CmdrZin/chips_pic_examples/README.md

chips_pic_examples
==================

Examples of PIC processor code in C and ASM. Mostly PIC12, PIC18, and dsPIC33 families.

| Name | Description |
|---|---|
|dsPIC33 | dsPIC33 board and code for simultaneous four channel ADC.  |
