CmdrZin/chips_pic_examples/dsPIC33/NewFasterDSP.rtf

NewFasterDSP.rtf
23jun20
04aug20

https://www.microchip.com/wwwproducts/en/dsPIC33CK256MP202 - dsPIC33CK256MP202 - No CAN, 3.5 MSPs, 12-bit.

https://www.microchip.com/wwwproducts/en/dsPIC33CK256MP202 - dsPIC33CK256MP502 - w/ CAN

- SST26VF064B 64Mb 104MHz Serial Flash 8pin

http://www.swarthmore.edu/NatSci/echeeve1/Ref/SingleSupply/SingleSupply.html - EDU web page for single
supply opamp circuits.

MCP602-I/P - Rail-to-Rail (100mv) Single supply 2.7v to 6.0v Dual Opamp DIP8
http://ww1.microchip.com/downloads/en/AppNotes/00682c.pdf - App note for opamps in embedded systems.
Use MCP6004-I/P Rail-to-Rail Quad 1.8v - 6.0v DIP14 1MHz
