CmdrZin/chips_pic_examples/dsPIC33/Notes_dsPIC33rev3.rtf

Notes_dsPIC33rev3.rtf
05aug20 ndp
12aug20

Notes on new dsPIC33 rev 3 board (Using DSPIC33EP32MC202)

CmdrZin : gelf..MC!
chip@gameactive.org

ref1: dsPIC33EPxxx.pdf - Data sheet.
ref2: dsPIC33_FRM_Osc.pdf (S7.pdf) - Oscillator configuration and uses manual (DS70580C).
ref3: dsPIC33_FRM_ADC.pdf (S16.pdf) - Analog-to-Digital Convertor users manual (DS70621C).
ref4: (see also) ..\DemoBoards\dsPIC33\dsPIC33_Sampler.X\docs DN and LN docs.
ref5: https://www.ftdichip.com/Products/ICs/FT232H.htm - FTDI chip ref

dsPIC33EP32MC202..Upgrade to DSPIC33EP512MC202 for 48k of RAM.
Power: 36 to 55 ma @ 3.3v @ 60 MIPS Use 0.1uF + 0.001uf at Vdd:Vss pairs and AVdd:AVss pins.[1] Sect 2.0 (see also pg30)
16uH inductor to Vdd. [1] pg 30 Fig 2-1
10uF Tantalum on Vcap (ESR < 1.0 Ohm). [1] pg 30 Fig 2-1
10uF Electrolytic local Vdd power tank cap. [1] pg 30 Fig 2-1
Jumper to disconnect /MCLR pin during debug and programming. [1] pg 30
IO: Unused pins should be driven LOW.[1] pg 32
CLOCK: Set Fvco = 240MHz. PLLPOST = 01 (div 4) for Fpllo = 60MHz

FTDI: https://www.ftdichip.com/Products/ICs/FT230X.html - FT230x chip $2.04 ea

https://www.microchip.com/mplab/mplab-x-ide - IDE v5.40 ..do FULL install (8,16,32 MCUs)
Harmony not installed. Some day maybe.
https://www.microchip.com/mplab/mplab-code-configurator - MCC..Tools > Plugins > MPLAB Code Configurator
https://www.microchip.com/mplab/compilers - Compiler Downloads > XC8, XC16, & XC32 for WIndows.
D:\Program Files\Microchip\<compiler folder>. If not adding to PATH, then
Run .exe file and config with Tools > Options > Embedded > Build Tools > Add or Scan to add compiler.
Resolve DSP pack needed. dsPIC33_Sampler builds..

New Schematic/Layout dsPIC33_Sampler_r3.sch, .pcb

Flash
SST25VF020B 2Mb SPI

Family differences[1]
dsPIC33EPxxxGP20x/50x - Have ECAN Interface. No PWM or Quadrature.
dsPIC33EPxxxMC20x/50x - Have PWM and Quadrature Interface. 20x -No ECAN. 50x - Has ECAN.
xxx Flash RAM
32 32k 4k dsPIC33EP32MC202
64 64k 8k
128 128k 16k
256 256k 32k
512 512k 48k

For FCY = 60 MHz [2]Sect 7.7.2.2 (error in Ex 7-2 code)
Let FOSC = 120 MHz
FIN = 7.37 MHz
Let FSYS = 240 MHz = FIN x (M/N1) = 7.37 x (65.13/2)
M = 65 (PLLDIV<8:0> = 63)
N1 = 2 .. (PLLPRE<4:0> + 2) .. PLLPRE<4:0> = 00000
FPLLI = FIN / N1 = 7.37 / 2 = 3.685 MHz < 8.0 MHz
FOSC = FSYS / N2 = 240 MHz / 2 = 120 MHz (119.76 MHz)
N2 = 2 .. (2 x (PLLPOST<1:0> + 1)) .. PLLPOST<1:0> = 0
Can uptune FRC (OSCTUN) a bit to get to 120 MHz if needed.

Configuring ADC
The 28-pin DIP only has 6 analog inputs and AN4 and AN5 are used by ISP programmer pins.
In ONE channel (12 bit) mode, AN0 goes to CH0.
In FOUR channel (10 bit) mode, AN3->CH0, AN0->CH1, AN1->CH2, and AN2->CH3. +Vref and -Vref can not be used.

TIMING
12 bit
TAD > 118ns TCONV = 14 TAD TSAMP >= 3 TAD [1]Table30-60
10 bit
TAD > 76ns TCONV = 12 TAD TSAMP >= 2 TAD [1]Table30-61
Set AD1CON3<7:0> to 4 (10bit) or 5(12bit) to get the correct TAD time.
FP = 1/60MHz = 16.7 ns
Set AD1CON3<7:0> to 4 (10bit) or 8(12bit) to get the correct TAD time.
Four conversions = 233kHz/4ch or 932kHz throughput.

Ground and Power layout
Use 5v for opamp.
LM386 LP filter set to ~16kHz ( 1k + 0.01uF ).
