CmdrZin/chips_pic_examples/dsPIC33/dsPIC33_serialExample.rtf

dsPIC33_serialExample.rtf
09sep19 ndp

see also D:\Downloads\Microchip\web-platform-dsPIC33Intro.v1a.zip

SEND
#define FCY 30000000

#include <xc.h>

#include <stdio.h>

#include <delay.h>

#include <libpic30.h>

#include <math.h>

#include <p30F4011.h>

_FOSC(CSW_FSCM_OFF & FRC_PLL16); // Fosc=16x7.5MHz, i.e. 30 MIPS
_FWDT(WDT_OFF); // Watchdog timer off
_FBORPOR(MCLR_DIS);

void UART_Init ( void )
{
_TRISF3 = 0; //Look for the exact TX/RX pins of your pic device
_TRISF2 = 1; //TX pin must be set as output port and RX input

U1BRG = 7; // 115000 baud rate @ 30 MIPS
U1MODEbits.UARTEN = 1; // Enable UART
}

int main( void )
{
UART_Init();

while( 1 )
{
//To print a variable
sprintf(array,"%d",variable);
printf(array);
printf("\r\n");

//To print text
printf("Greetings from Pakistan\r\n");

__delay_ms(1000);
}
}

RECEIVE
#define FCY 30000000

#include <xc.h>

#include <stdio.h>

#include <libpic30.h>

#include <uart.h>

#include <delay.h>

#include <p30F4011.h>

// Configuration settings
_FOSC(CSW_FSCM_OFF & FRC_PLL16); // Fosc=16x7.5MHz, Fcy=30MHz
_FWDT(WDT_OFF); // Watchdog timer off
_FBORPOR(MCLR_DIS); // Disable reset pin

char data;

void Interrupt_Init( void )
{
IEC0bits.U1RXIE = 1;
}

void __attribute__((interrupt, auto_psv)) _U1RXInterrupt( void )
{
_LATD0 = 1;
__delay_ms(500);
_LATD0 = 0;

data = U1RXREG;

if ( U1STAbits.OERR = 1 )
{
U1STAbits.OERR = 0;
}
IFS0bits.U1RXIF = 0;
}

int main()
{
// Set all port D pins as outputs
_TRISD0 = 0;

// Setup UART - most default options are fine
UART_Init();
Interrupt_Init();

while(1)
{
__delay_ms(1000);

}

return 0;
}
