CmdrZin/chips_pic_examples/dsPIC33/Notes_dsPIC33.rtf

Notes_dsPIC33.rtf
20jan17 ndp
13jun20

Notes on dsPIC33 controller (Using DSPIC33EP32MC202)

CmdrZin : gelf..MC!
chip@gameactive.org

ref1: dsPIC33EPxxx.pdf - Data sheet.
ref2: dsPIC33_FRM_Osc.pdf - Oscillator configuration and uses manual.
ref3: dsPIC33_FRM_ADC.pdf - Analog-to-Digital Convertor users manual.
ref4: (see also) ..\DemoBoards\dsPIC33\dsPIC33_Sampler.X\docs DN and LN docs.

https://www.microchip.com/mplab/mplab-x-ide - IDE v5.40 ..do FULL install (8,16,32 MCUs)
Harmony not installed. Some day maybe.
https://www.microchip.com/mplab/mplab-code-configurator - MCC..Tools > Plugins > MPLAB Code Configurator
https://www.microchip.com/mplab/compilers - Compiler Downloads > XC8, XC16, & XC32 for WIndows.
D:\Program Files\Microchip\<compiler folder>. If not adding to PATH, then
Run .exe file and config with Tools > Options > Embedded > Build Tools > Add or Scan to add compiler.
Resolve DSP pack needed. dsPIC33_Sampler builds..

09sep19
d/l MLA (libraries for USB and crypto) [https://www.microchip.com/mplab/microchip-libraries-for-applications]
Upgrade to MPLAB XIDE 5.25.
16sep19
Remove MIC preamp. Correct Serial Flash interface. Add decoupling to opamps. Update I2C layout.
New Schematic/Layout dsPIC33_Sampler_r1.sch, .pcb

Flash
SST25VF020B 2Mb SPI

Family differences[1]
dsPIC33EPxxxGP20x/50x - Have ECAN Interface. No PWM or Quadrature.
dsPIC33EPxxxMC20x/50x - Have PWM and Quadrature Interface. 20x -No ECAN. 50x - Has ECAN.
xxx Flash RAM
32 32k 4k dsPIC33EP32MC202
64 64k 8k
128 128k 16k
256 256k 32k
512 512k 48k

NOTE: dsPIC33EPxxGS50x has 5 simultanious 12 bit ADC and 2 12 bit DAC @ 3.5 MHz.

Configuring the dsPIC33 CPU clock
Uses on-chip PLL to boost osc to faster CPU clock.[1]Sect 9
Fuse bits select osc source.[2]Sect 7.1
Using internal FRC @ 7.37 MHz.[1]Table 30-19
FOSCSEL: FNOSC<2:0> = 0b111 for start up.[2]Sect 7.3
FOSC: 0003 - POSCMD<1:0> = 0b11 disabled

Inst Clock: FCY = FOSC/2 (70 MHz max)
FOSC = FPLLO <= 140 MHz. [2]Fig 9-2
FPLLO = FIN x (M /(N1 x N2))
N1 = PLLPRE + 2
N2 = 2 x (PLLPOST + 1)
M = PLLDIV + 2
120 MHz < FVCO < 340 MHz
FVCO = FIN x (M/N1)

OSCCON settings 0b0rrr 0001 00r0 rrrs
NOSC<2:0> = 0b001 - Switch to FRC w/ div and PLL

CLKDIV settings
ROI = 0
DOZE<2:0> = 000
DOZEN = 0
FRCDIV<2:0> = 000
PLLPOST<1:0> (N2) = 00 (/2) or 01 (/4)
PLLPRE<4:0> (N1) = 0 (/ n+2)

PLLFBD settings
PLLDIV<8:0> (M) = y (/ y+2)

OSCTUN setting 0x0000 - no adjustment

REFOCON settings 0x0000 - disabled

For FCY = 70 MHz
Let FOSC = 140 MHz
FIN = 7.37 MHz
Let FSYS = 280 MHz = FIN x (M/N1) = 7.37 x ( 75.98/2)
M = 76 (PLLDIV<8:0> = 74)
N1 = 2 .. (PLLPRE<4:0> + 2) .. PLLPRE<4:0> = 00000
FPLLI = FIN / N1 = 7.37 / 2 = 3.685 MHz < 8.0 MHz
FOSC = FSYS / N2 = 280 MHz / 2 = 140 MHz (140.03 MHz)
N2 = 2 .. (2 x (PLLPOST<1:0> + 1)) .. PLLPOST<1:0> = 0
Can detune FRC (OSCTUN) a bit to get to 140 MHz if needed or use M=75 to get 138.2 MHz.

For FCY = 60 MHz [2]Sect 7.7.2.2 (error in Ex 7-2 code)
Let FOSC = 120 MHz
FIN = 7.37 MHz
Let FSYS = 240 MHz = FIN x (M/N1) = 7.37 x (65.13/2)
M = 65 (PLLDIV<8:0> = 63)
N1 = 2 .. (PLLPRE<4:0> + 2) .. PLLPRE<4:0> = 00000
FPLLI = FIN / N1 = 7.37 / 2 = 3.685 MHz < 8.0 MHz
FOSC = FSYS / N2 = 240 MHz / 2 = 120 MHz (119.76 MHz)
N2 = 2 .. (2 x (PLLPOST<1:0> + 1)) .. PLLPOST<1:0> = 0
Can uptune FRC (OSCTUN) a bit to get to 120 MHz if needed.

For FCY = 40 MHz
Let FOSC = 80 MHz
FIN = 7.37 MHz
Let FSYS = 160 MHz = FIN x (M/N1) = 7.37 x (65.13/3)
M = 65 (PLLDIV<8:0> = 63)
N1 = 3 .. (PLLPRE<4:0> + 2) .. PLLPRE<4:0> = 00001
FPLLI = FIN / N1 = 7.37 / 3 = 2.46 MHz < 8.0 MHz
FOSC = FSYS / N2 = 160 MHz / 2 = 80 MHz (79.84 MHz)
N2 = 2 .. (2 x (PLLPOST<1:0> + 1)) .. PLLPOST<1:0> = 0
Can uptune FRC (OSCTUN) a bit to get to 80 MHz if needed.

Configuring ADC
The 28-pin DIP only has 6 analog inputs and AN4 and AN5 are used by ISP programmer pins.
In ONE channel (12 bit) mode, AN0 goes to CH0.
In FOUR channel (10 bit) mode, AN3->CH0, AN0->CH1, AN1->CH2, and AN2->CH3. +Vref and -Vref can not be used.

TIMING
12 bit
TAD > 118ns TCONV = 14 TAD TSAMP >= 3 TAD [1]Table30-60
10 bit
TAD > 76ns TCONV = 12 TAD TSAMP >= 2 TAD [1]Table30-61
If using system clock for conversion, AD1CON3:ARDC=0, then
FP = FOSC/2 = FCY (if DOZE = 1) = 1/40MHz = 25 ns
Set AD1CON3<7:0> to 4 (10bit) or 5(12bit) to get the correct TAD time.
FP = 1/60MHz = 16.7 ns
Set AD1CON3<7:0> to 5 (10bit) or 8(12bit) to get the correct TAD time.
Four conversions = ~5.68us or 176kHz/4ch or 704kHz throughput.

AUTO-CONVERT
AD1CON3.SAMC<4:0> = 3 TAD
SSRCG = 0 SSRC<2:0> = 111

SIMULTANEOUS SAMPLING
AD1CON1.SIMSAM = 1
Test AD1IF bit for convsersion complete. (IFS0.AD1IF Interrupt flag, but currently not using interrupts.)
Total loop now at 195kHz for four channels, includes reading and running through IF block..try logic..ok.
Still works..save it..

Configuring UART (Sect 10, pg 10-14)
//*************************************************************
// Unlock Registers
//*************************************************************
__builtin_write_OSCCONL(OSCCON & ~(1<<6));

RB11/RP43 is mapped to U1RX RPINR18bits.U1RXR = 0 010 1011 (DataSheet pg 191, REGISTER 11-10)
RB10/RP42 is mapped to U1TX RPOR4bits.RP42R = 000001

(DataSheet TABLE 11-2)
RP43 = 010 1011
RP42 = 010 1010

//*************************************************************
// Lock Registers
//*************************************************************
__builtin_write_OSCCONL(OSCCON | (1<<6));

Set up BAUD rate. S17.pdf Example 5-1 pg18

Check U1STAbits.URXDA == 1 for data available. U1RXREG has data.
If U1STAbits.OERR == 1, set to 0 to continue.
Write to U1TXREG to send data.
TX and RX buffers are 4 level FIFOs.
