CmdrZin/chips_pic_examples/dsPIC33/UltraSonicArray/DN_UltraSonicArray.rtf

DN_UltraSonicArray.rtf
15jan17 ndp

Design Notes for an Ultra Sonic Array Imager/Sensor (finally..only been what..10 years since first consept?)

ref1:

Using dsPIC33 Sampler board. 70 MHz DSP with quad 250kHz simultainius sampling, 2Mb storage,
FTDI/USB/Bluetooth port, and I2C (both 5v and 3.3v).

40kHz transducers. One emitter, four receivers.

FFT at 40kHz for phase information. (ref linear array for radar papers and MatLab examples)
