CmdrZin/chips_pic_examples/dsPIC33/Processing3/Notes_Processing3.rtf

Notes_Processing3.rtf
05sept17 ndp

Notes on Using Processing3 with focus on Serial Comm and Graph/Text Displays

Processing3 is really a Java Applet to present a simplified framework.
Graphic coordinates based on 0,0 in upper left corner.
Use text( String, x1, y1, x2, y2) to display text in FONT defined.
hex(v) returns a String object of v converted into HEX.
