CmdrZin/chips_pic_examples/dsPIC33/dsPIC33_Sampler.X/docs/LN_dsPIC33_Sampler.rtf

LN_dsPIC33_Sampler.rtf
06jan17 ndp
15jul20

Log Notes for dsPIC33 High Speed Sampler

ref1: dsPIC33_FRM_Osc.pdf
ref2: dsPIC33_FRM_ADC.pdf

Target: Microchip dsPIC33 family, dsPIC33EP32MC202 @ 60Mips, 500kHz ADC, 2Mb serial Flash 10MHz

04sep19
TODO: Change I2C to revised layout. (../I2C_Reference/I2C_Ref.rtf)
Add Ext 5v input pins. Power 3.3 is usually from FTDI serial.

Open up MPLAB X IDE
File > New Project > Samples > dsPIC33 C Template (try this) > Next
Project Filename: dsPIC33_Sampler
Project Loacation: C:\Data\EmbeddedSystems\Demo Boards\dsPIC33
Project Folder: C:\Data\EmbeddedSystems\Demo Boards\dsPIC33\dsPIC33_Sampler.X .. Set as Main Project
Propertues > Configuration > Device > dsPIC33EP32MC202 > Apply .. hmm
Family: 16-bit DSCs (dsPIC33) > Device > dsPIC33EP32MC202 > Compiler Toolchains > XC16 > XC16 (v1.30) > Apply > OK
Toolbar: Config: XC16_dsPIC33EP512MU810..hmm..no source errors now..ok..
Use main.c for most.
Use user.c to init hardware.
Open getting_started.tx file in project browser.. go to Windows > Tasks to get a list of set up tasks..ok.
Step 1: Clean and Build..try build initial set up..ok..
Step 2: configuration_bits.c set up .. Window > PIC Memory Views > Configuration Bits
Use 7.7.2.2 Exp 7-2[1] code for internal osc @ 60 MHz .. also turn off watchdog .. gen code..cut-n-paste to configuration_bits.c
Add main() code to system.c: ConfigureOscillator() .. leave Disable WDT code.. Clean and Build..ok..
07jan17
Step 3: Skip for now. No interrupts.
Step 4: system.h, .c. Hmm..nothing at the moment. ConfigureOscillator(void) already there.
Step 5: user.c, .h .. Configure I/O, ADC, etc... just I/O for now. RB4 pin 11 as output. Add LED function setLed(bool).
make some guesses on code based on data sheet section 11. Do perif mapping later.
Step 6: add some trivial loop code to blink LED..ok..plug in Uo for 3.3v and ICD 3..hmm, wrong target..
try setting EP32 (copy of EP512) as configuration..clean/build..hmm..config bits unknown..delete offending lines..
hmm..since setting target in config, different bits available. Redo 7.7.2.2 Exp 7-2[1] for Osc and gen code..try c/b..
ok..try make and prog to device..hmm..no errors, but no LED..try debug..DOH..not inc count..FIX..hmm..
try debug again..hmm..only runs in Debug (but very slow)..clock issue?..hmm, left out last line..FIX..try again..same..
FNOSC = FRC 7.6 Table 7-4
try dropping clock..63 -> 10..debug is slower..no run yet..try N1=2..faster debug, no run..
try seting Analog to Digital..nope..add pull up to MCLR..YUP..runs now, but slow..code is minimal and flow is ok..
try..
FOSCEL:FNOSC=FRCPLL .. nope..
TUN<5:0> sets rate, NO, minor adj. FRCDIV..can control, starts at div 1..ok..USLESS RABBIT HOLE..
Was using int for counter, well half the time it's NEGATIVE and counter % ^ won't be 0 OR 6..FIX by using uint16_t
and ALL WORKS at speed (about 50 MHz).
08jan17
ADC[2] .. No DMA .. with OpAmps ..
AN0 Ch0 CH0Sx = 00000
AN1 Ch1
RB0 -Vref CH0Nx = 0, VCFG<2:0>
RB1 +Vref VCFG<2:0>
Use Section 16 Example code 16-1[2] .. put initAdc1() code in user.c:InitApp() ..
Set SIMSAM = 1 for simultaneous sampling..CHPS<1:0> for channels 0 and 1 .. 0 for now..
Change AD1CHS0 = 0x0000; to use AN0 .. add led blinks to measure acquisition time..
TODO: Use AD1CON2:VCFG = b001 for Ext +VRef and AVss (frees up RB0)
TODO: For two channel, set AD1CON2:CHPS = b01
try it.. hmm about 75kHz (13us) per .. ok .. add some code to check data to threshold .. hmm .. no response ..
try uint16_t .. nope .. oops, wrong port .. FIX .. ok, works. Can try other combinations later..
commit ..
NEXT: four channels using +Vref=Vdd and -Vref=Vss
Ch0: AN3/RB1 (5)
CH2: AN1 (3)
Ch1: AN0 (2)
Ch3: AN2/RB0 (4)
19jan17
Change over to new ADC configuration, four channels.
MOD: user.c,.h : InitApp() .. change to select 1 ch or 4 ch config.
MOD:main.c to select either one or four chanel adc..try it..hmm..oops..x0200 is not bit 10, x0400 is..fix..
PROBLEM: Target Device ID (0x0) does not match expected Device ID (0x1c010000)
NOTE: Add 10k pull-down to PGC and PGD lines. ICD3 issue fix.
One channel working with 12bit now..try 4 chan..works..a little slow (13.4us convert)..try internal RC osc
AD1CON3 = 0x8000; // ADRC:IntRC, SAMC:n\a, ADCS:n\a
better..(11.94us)..hmm..Sect 16[2] says to use 40MHz to get 1.1MHz..change clock set up per Ex 16-3.
MOD: system.c : ConfigureOscillator() .. better..go back to 70MHz and adj TaD value..still works..ok.
20jan17
MOD: main.c, user.c - Added auto-sample/auto-convert to FOUR channel adc code.
ALL: Added MIT license to code.
Hooked up LED to pin25 (RB14/PWM1)
MOD: main.c, user.c to enable RB14 as output and toggle with 3 nops between toggles .. works .. 0.12us pulse..
6 instruction in 0.12us -> 50MHz .. hmm .. put in 7 nops for 10 inst per edge .. 0.2us with some 0.16us areas ..
Seems TCY is 50MHz. Should be 60MHz or the saleae pod is off a bit..increase to 20 Tcy..hmm..0.36 and 0.40..
try 100 Tcy..1.68 & 1.72us -> 58 to 59 MHz..so 25 MHz sampling of pod is issue..ok..
Save ADC as test002..start PWM stuff..not simple..
17mar17
Board built up except for audio pre-amp..power up MPLAB X IDE..call test001 code..Make and Program Device..
50 Hz LED Blink..IT'S ALIVE!!!!..cool..need a 3.3v FTDI or Bluetooth to read out data..next up try ADC code..
09sep17
ICD 3.. Debug > Test ..make sure to select serial number and not just ICD 3..ok with test board..works now.
Insupported interrupt going to trap..turn OFF TX Intr..ok..hmm, trace register settings, S17.pdf Sect 5.0 TX..
MOD test001 to load U1TXREG when LED is turned on. Should work w/o intr..ok..trace intr service def..at 9600 too..
data seems inverted..hmm, http://microchipdeveloper.com/faq:77 - notes. Try in code..nope..try CCI syntax..
nope..(from trap.c) need a prototype of ISR??..try it..nope..try moving ISR into main()..YES??..hmm, put prototype
in main.c??..nope..try putting a function to call in serial.c..DOH, didn't add serial.c,.h to Projects > Source Files ..
FIX..Projects > Source Files > Add Existing Item.. and pick files..works now..sheesh..
NOTE: UTXINV bit controls output polarity.
NOTE: UTXBF bit = 1 if TX buffer fifo is full.
09sep19
Serial support. Add writeChar() and writeBuff(). ConfigureUART: dont use .bits for entire register set..
HAH, works now. Try for 115.2k now..change Processing3 code..ok, works..
12sep19
Revised ADC (test02)..5us -> 200KHz per 4 channel -> 800KHz total rate..cool..
TODO: Add interrupt service to transfer ADC data to buffer. Print out working, no interrupt yet.
13sep19
CHPS<1:0> = 1x = 3, ok.. SMPI<4:0> = 4 ? .. IFS0bits.AD1IF = 0, IPC3bits.AD1IP = 7 (highest), IEC0bits.AD1IE = 1 ..ok..
HAH, works now..format data out..ok, better. Now saving 512x4 samples in buffer.
17sep19
PWM .. ref: dsPIC33_FRM_PWM.pdf (S14.pdf) .. RB14/PWMH (RPI46) pin.
Use PWM1H. FP = 60HMz. IOCON1 and FCLCON1 are write-protected. (16.1.2 data sheet).
Use Standard Edge-aligned PWM.
PWMCON1bits.CAM = 0; // For Edge-Aligned mode.
ref: fig 14-35, Example 14.34
PHASE1 = 800; // period
PDC1 = 200; // duty cycle
DTR1 = 0; // Dead time
ALTDTR1 = 0;
IOCON1 = 0xCC00; // PWM Mode to Independent
PWMCON1 = 0x0200; // Ind time base, edge-align, independent duty cycle
FCLCON1 = 0x0003; // Configure Faults
PTCON2 = 0x0000; // 1:1 prescaler
PTCON = 0x8000; // Enable PWM Mode
add to system.c .. configurePWM() .. try it.. works.. 60000=2kHz, 12000=10kHz periods.
For interrupt, try
TRIG1 = 0x0010;
PWMCON1bits.TRGIEN = 1;
TRGCON1 = 0x0000;
IFS5bits.PWM1IF = 1; // enable by resetting interrupt flag?
IPC23bits.PWM1IP = 0b001; //interrupt priority level 0 .?
blah..
PTCONbits.SEIEN = 1;
nope..bug, fix..working..now to remove added code that may not be needed..TODO.
19sep19
Add audio code. Use Period=2048 (73.5kHz period sample time)
36750/256 = 143.5Hz so 146.83Hz (D3) 36750/x = 146.83, x=250.289. x*8 = 2002.
Test..185.2Hz..close..try 1800 accumStep ..=161.3Hz..try 1600..=142.8..1620..=144.9..use 1610.
610 -> 55.5 Hz..ok.
20sep19
Change R7 to 1k. Better. Added Tune code..add pause to notes..ok, working..
24sep19
Add envelope code..scaling problems..add P_IDLE state to end envelope, going back to P_ATTACK caused /0 error
due to counter at 0..fixed..steps have to equal 100% of duration or clicks are generated..working now.
28jun20
BUG: Four channel data is invalid.
Have interrupt place incrementing count as data into buffer to test transfer...works correctly..00 01 02 03..
So, ADC measured values have a problem..review manual Ch 16..system noise at about 200kHz..minor adjustments
to code..seems to work now.
15jul20
OpAmps clip at 2v. DC Bias is at 1.615v. Reduce signal. Audio still works. Snashot to SVN rev 340.

15jul20
Project rev 341.
Modify dsPIC + Processing3 O-display to show serial data.
1. Change serial format to add sync 0xAA 0x55 before data. Change data to be 16 bit. Modify Processing3 to accept.
Four channel is 8bit. One channel is 12bit.
New format: AA 55 Ch0H Ch0L Ch1H Ch1L Ch2H Ch2L Ch3H Ch3L 0A 11 bytes with '\n' terminator.
New SYNC Format: AA 50 2 8bit binary bytes. New buffer dump.
New Binary Format (Four Chanel): AA 55 Ch0 Ch1 Ch2 Ch3 6 8bit binary bytes
DSP side done..Looks ok on scope.
Do Processing3 side..

New Binary Format (One Chanel): AA 5N ChNH ChNL 4 12bit binary bytes. N = Chan

Dump entire buffer every 2k samples.
Add a zero, F8 to 08, crossing trigger to start collection.

2. Copy ..\Software\Processing3\OScope code to ..\Processing3\OScope4Ch and add in code from SerialTest002 then
modify to accept new format.
