CmdrZin/chips_pic_examples/dsPIC33/dsPIC33_Sampler.X/docs/DN_dsPIC33_Sampler.rtf

DN_dsPIC33_Sampler.rtf
26dec16 ndp
15jul20

Design Notes for dsPIC33 Sampler board

Using: dsPIC33EP32MC202 device

Target: Microchip dsPIC33 family, dsPIC33EPxxxMC202 @ 60Mips, 500kHz ADC, 2Mb serial Flash 10MHz

This board will evaluate the dsPIC33xxx for fast ADC 500kHz > 1100kHz(quad sample) and analog input circuits.
It is a 3.3v system and will need a translator for I2C to 5v systems.

Single channel audio tests use preamp into AN0 and PWM audio out. ADC is configured for 12bit 500kHz max.
Quad channel (ultrasonic) tests use AN0-3 and simultainiuos sampling. ADC is at 250kHz per channel or 1MHz.

DSP: Microchip DSPIC33EP32MC202
DSPIC33EP32MC202-I/SP-ND IC MCU 16BIT 32KB FLASH 28SDIP 1: 2.1800 25: 1.9984 100: 1.8128
dsPIC dsPIC™ 33EP Microcontroller IC 16-Bit 70 MIPs 32KB (10.7K x 24) FLASH 28-SPDIP

ADC Vref: 2.5v have stock Vdd (3.3v)
Inputs have 1.25v 1.615v offset to generate signed values about 1.25v base line.
+Vref: Ch0: AN3/RB1 (5)
Ch1: AN0 (2)
CH2: AN1 (3)
-Vref: Ch 3: AN2/RB0 (4) or VSS
NOTE: Reconfigure for VDD/VSS for ADC +Vref/-Vref to use MAX4467 PreAmp..Use 2.5v for dual inputs w/offset.

Serial Flash: Microchip SST25VF020B, SIOC 8-DIP
SST25VF020B-80-4I-SAE-TCT-ND IC FLASH 2MBIT 80MHZ 8SOIC 1: 0.7000 25: 0.6800 100: 0.6489

Mic Input: Adafruit, Electret Microphone Amplifier - MAX9814 with Auto Gain Control, PRODUCT ID: 1713 $7.95
MAX9814ETD+TCT-ND IC AMP AUDIO MONO AB MIC 14TDFN 1: 1.5100 10: 1.4280 100: 0.9996
MAX4467EKA+CT-ND IC PREAMP AUDIO MONO AB SOT23-8 1: 0.8100 10: 0.7700 100:0.5400

Audio Out: LM386N-3 have stock

Serial COMM: Connector to FTDI:USB module.
http://dangerousprototypes.com/docs/Introduction_to_dsPIC33_programming - Example code and set up.
PPS Reg 11-10 U1RXR RP43 = 010 1011
PPS Reg 11-22 U1TXR RP42 = 0x01

Set up serial.c,.h and use system.c to configure UART. (ref S17.pdf)

Target Baud Rate: 115.2kHz @10 bits / char -> ~10kHz / byte 1024 sample/window > 10Hz rate

ADC Collection
ADC Vref: Vdd (3.3v)
Inputs have 1.615v DC offset to generate signed values about 1.615v base line.
Channel (pin)
Ch0: AN3/RB1 (5)
Ch1: AN0 (2)
CH2: AN1 (3)
Ch 3: AN2/RB0 (4)
NOTE: DMA only available when using one ADC channel. (dsPIC33EP data sheet table 8-1.)
Four channel system uses 10bit ADC. (16.6.1)
InitApp() configures the ADC/SH system and assigns Analog Input pins.
NOTE: CHPSx bits are in AD1CON2. SIMSAM is in AD1CON1. 10bit mode: AD21B=0.
Currently Unsigned Int (10bit). Auto sample.
Tests: 5us -> 200KHz per channel x4 channels -> 800KHz total rate.
Set up a big buffer and sample 2048 bytes -> 512 x 4 channels. Need to shift data to convert to bytes or set
FORM<1:0> = 10 (23-1 AD1CON1 reg) then use upper byte or leave as is and shift >>2 then cast to char.
Add interrupt service to transfer ADC data to buffer. Follow check list.

15jul20
Project rev 341.
Modify dsPIC + Processing3 O-display to show serial data.

1. Change serial format to add sync 0xAA 0x55 before data. Change data to be 16 bit.
New format: AA 55 Ch0H Ch0L Ch1H Ch1L Ch2H Ch2L Ch3H Ch3L 0A 11 bytes with '\n' terminator.
Dump entire buffer every 2k samples.
Add a zero, F8 to 08, crossing trigger to start collection.

2. Copy ..\Software\Processing3\OScope code to ..\Processing3\OScope4Ch and add in code from SerialTest002 then
modify to accept new format.

PWM Audio
ref: dsPIC33_FRM_PWM.pdf (S14.pdf)
RB14/PWMH output pin.
tests show 60000=2kHz, 12000=10kHz periods. Use 4:1 div 3000=10kHz 1024=~30kHz and 10bit PWM.
2048=58.6kHz 11bit PWM. (73.5kHz measured) Need sharper LP filter. Line out: TL082C dual opamp. Add PWM2H.
DDS will need PWM interrupt each period. uint16_t duration for 2sec max note. duration tic each period.
Put PWM interrupt in audio.c file. Change R7 to 1k ohm to set LP filter at 1.6kHz instead of 10kHz.
73500/256 = 287Hz i.e. one wave using all points. (accumStep = 256>>8). Change to 2:1 clock, then
36750/256 = 143.5Hz so 146.83Hz (D3) 36750/x = 146.83, x=250.289. x*8 = 2002.
use 1610 to get 143.5 Hz. Values should scale linearly. Octaves double frequency.

pwmDuty = nextValue;
if (duration > 0) {
-- duration;
indexAccum += accumStep;
indexAccum >>=8; // convert to uint8_t table index.
nextValue = table[ indexAccum ];
} else {
// get next note.
if (tuneLength > 0) {
duration = noteTablePtr[].duration;
accumStep = noteTablePtr[].accumStep;
} else {
// stop tone generation.
PWM1CON.ENABLE = 0;
}
}

Add tone tables. Change LP filter.
Tune Table
typedef struct ttEntry {
uint16_t note; // note phase time
uint16_t duration; // play time. N * 13.6 us. max duration 0.891 sec.
} TT_ENTRY;

typedef struct tuneTable {
char numEntries; // number of note & duration entries
TT_ENTRY notes[];
}

Add pause between notes to sound like key hits. TODO:Attack/Sustain/Decay will do this later.

ADSR: Attack Decay Sustain Release
Attack, Decay, and Release are all the same period. Sustain is the Note Duration.
A = D = R = 2000. S = duration
A: 0 -> 100% (0 -> 255) D: 100% -> 80% (255 -> 200) R: 80% -> 0% (200 -> 0) S: 80% (200)

/* Globals */
typedef enum { P_ATTACK, P_DECAY, P_SUSTAIN, P_RELEASE } PHASE_STEP;
uint16_t attackSteps;
uint16_t decaySteps;
uint16_t sustainSteps;
uint16_t releaseSteps;

/* set time (in sample steps) of each phase of the envelope.
* Percentage of tone duration for each phase.
* Attack 10%
* Decay 10%
* Sustain 70%
* Release 10%
*/
initEnvelope(uint16_t sustain) {
attackSteps = sustain/10;
decaySteps = sustain/10;
sustainSteps = sustain;
releaseSteps = sustain/10;
phaseStep = P_ATTACK;
}

/* Called each sample.
* Percentage of tone duration for each phase.
* Attack 10%
* Decay 10%
* Sustain 70%
* Release 10%
*/
uint16_t getEnvelope() {
// --attackSteps to 0 while increasing attackAmplitude from 0 to 255
// same for other phases.
}
Gain returned is 16bit to multiply the 11bit wave phase value. Use long data types.
(int)(((long)wave<<5 * (long)gain) >> 16)
if durration < 256, then use 255 / duration. else use duration / 255. Need 16bit accumulator then >>8.
Smallest duration is 8k. So 10% is 800.
((uint16_t)(255<<8)) / attackSteps = amplitudeStep. ((phaseGain<<8) + amplitudeStep) >> 8.
Idea: Subtract ADR duration from S duration to keep the total equal to the Note Duration.
