CmdrZin/chips_pic_examples/dsPIC33/Processing3/OScope4Ch/LN_OScope4Ch.rtf

LN_OScope4Ch.rtf
27jul20 ndp

Log Notes for a 4Ch OScope display using 115.2 kBaud serial input.

Set screen display to 1280 px x 1024 px. Grid size to 1000 px x 800 px with a 10 x 8 grid.
Basic display working. Add channel parameter (0-3) to test display rate and set channel color. Add 3 more buffers.
Add channel enable/disable check boxes.
Add channel vertical gain controls.
Added Serial interface. Check if no Serial Ports..ok. Fix channel colors..ok.
Add serial data text display list for DEBUGGING..ok.

TODO: Change ADC data format to signed 10bit (ssss sssd dddd dddd) and change serial data format to ..
Input format: Binary data in ASCII HEX format
AA 55 Ch0H Ch0L Ch1H Ch1L Ch2H Ch2L Ch3H Ch3L 0A 11 bytes with '\n' terminator.
TODO: Add channel vertical offset controls.
TODO: Need a set sample rate command.
TODO: Need a set One Channel/Four Channel command.
