CmdrZin/chips_pic_examples/dsPIC33/Processing3/OScope4Ch/DN_OScope4Ch.rtf

DN_OScope4Ch.rtf
04jul20 ndp
16jul20

Design Notes for a 4Ch OScope display using 115.2 kBaud serial input.
Input format: Binary data in ASCII HEX format
AA 55 Ch0H Ch0L Ch1H Ch1L Ch2H Ch2L Ch3H Ch3L 0A 11 bytes with '\n' terminator.
for One channel, use
AA 55 Ch0H Ch0L 0A 11 bytes with '\n' terminator.
and detect one channel/four channel in serial receiver code.

DONE: Set screen display to 1280 px x 1024 px. Grid size to 1000 px x 800 px with a 10 x 8 grid.

Basic display working. Add channel parameter (0-3) to test display rate and set channel color. Add 3 more buffers.
Add channel vertical gain and offset controls. Add channel enable/disable check boxes.

Need a set sample rate command. Need a set One Channel/Four Channel command.
