CmdrZin/chips_pic_examples/dsPIC33/BOM_RAW_dsPIC33_r3_Sampler.rtf

C1 10uF 493-12763-1-ND
C2,C3,C10 1.0uF P15831CT-ND
C4 4.7uF P5177-ND
C5,C9,C17 0.1uF 399-9859-1-ND
C6,C7 47pF 399-7917-1-ND
C8 0.01uF P4922-ND
C11,C13,C15 0.1uF 1276-1007-1-ND
C12 0.001uF 0805 SMD
C14 10uF 493-7383-1-ND
C16 0.1uF BC1127CT-ND
C18 0.047uF BC2686CT-ND
C19,C24 220uF P5166-ND
C20,C21,C22,C23,C25 1uF 399-1284-1-ND
D1 1N4001 1N4001MSCT-ND
D2,D3,D4 RED 511-1286-1-ND
D5 GRN 160-1426-1-ND
GND Test Post 929834-02-36-ND
J1 DIN 2.1mm CP-102A-ND
J2 RJ-12 6-6 A9031-ND
J3 USB Micro-B 609-4618-1-ND
J5 Header 2-Pin 929834-02-36-ND
J7 5x2 Header
J14 E
J16 F
J17 G
J18 H
JP1 Jumper 929834-02-36-ND
L1 15uH 732-2618-1-ND
L2 2.2mH AIAP-01-222K-TCT-ND
R1 2.2k 470EBK-ND
R2 10k CF14JT33K0CT-ND
R3,R6,R20 470 0805 SMD
R4,R5 27 0805 SMD
R7 1k CF14JT1K00CT-ND
R8 100k 100KEBK-ND
R9 10k 490-2970-ND
R10 10 CF14JT10R0CT-ND
R11,R12,R13,R14,R15,R16,R17,R18 100k A130146CT-ND
R19 1k CF14JT1K00CT-ND
SP1 8 ohm Speaker
SW1 SPDT SSW-46
SW2 RESET PB-126
TP1 Test Post 929834-02-36-ND
TP2 Test Post 929834-02-36-ND
TP3 Test Post 929834-02-36-ND
TP4 Test Post 929834-02-36-ND
TP5 Test Post 929834-02-36-ND
TP6 Test Post 929834-02-36-ND
U1 MCP1700 MCP1700-3302E/TO-ND
U2 dsPIC33EPxxxMC202 DSPIC33EP32MC202-I/SP-ND
U3 FT230X 768-1135-1-ND
U4 LM386-3 296-43959-5-ND
U5 SST25VF020B SST25VF020B-80-4I-SAE-TCT-ND
U6 MCP6004 MCP6004T-I/SLCT-ND
