CmdrZin/chips_pic_examples/dsPIC33/BOM_dsPIC33_Sampler.rtf

C7,C16 100pF NTE-89110-10
C19 0.01uF P4922-ND
C10 0.047uF BC2686CT-ND
C4,C5,C8,C12,C13,C14,C15,C17,C20 0.1uF BC1127CT-ND
C1 0.22uF 493-1137-ND
C2 1.0uF P15831CT-ND
C18 1uF BC1168CT-ND
C6 10uF 493-7383-1-ND
C9 47uF P5137-ND
C11 220uF P5166-ND
D1 1N4001 1N4001MSCT-ND
D2 RED SMD 0805 511-1286-1-ND
D4 RED LED B4304H1-25PK
J1 DIN 2.1mm
J2 RJ-12 6-6 A9031-ND
J3,J4 HDR 4PIN 929834-02-36-ND
J5,J7,J8,J9,J10 Header 2-Pin 929834-02-36-ND
J6 HDR 6PIN Long S1311EC-40-ND x6
J11,J12,J13,J14,J15,J16,J17,J18 A,B,C,D,E,F,G,H
JP2,JP3,JP4,JP5 Jumper 929834-02-36-ND
L1 10uH M10135-ND
M1 Mic - Electret CMA-4544PF-W
R1,R3 470 470EBK-ND
R2 33k CF14JT33KCT-ND
R4,R5 10k 10KOHM
R6 200k CF14JT200KCT-ND
R7 150 CF14JT150RCT-ND
R9 10k 490-2970-ND
R10 10 CF14JT10R0CT-ND
R8,R11,R12,R13,R14,R15,R16,R17,R18,R19 100k 100KEBK-ND
R20 10k 10KOHM
R21,R22 390k CF14JT390KCT-ND
R23,R24 1.2k CF14JT1K20CT-ND
SP1 8 ohm Speaker
SW1 SPDT SSW-46
SW2 RESET PB-126
TP1,TP2,TP3,TP4,TP5,TP6 Test Post 929834-02-36-ND
U1 LM7805 MC7805CT-BPMS-ND
U2 MCP1700 MCP1700-3302E/TO-ND
U3 dsPIC33EPxxxMC202 DSPIC33EP32MC202-I/SP-ND
U4 PCA9306 568-4215-1-ND
U5 SST25VF020B SST25VF020B-80-4I-SAE-TCT-ND
U6 LM386-3 296-43959-5-ND
U7,U8 LM358 LM358ANFS-ND
U9 MAX4467 MAX4467EKA+CT-ND
