CmdrZin/chips_pic_examples/dsPIC33/BOM_dsPIC33_Sampler_Rev3_0.ods

08/11/20 |  | dsPIC33 Sampler Rev 3
Quantity |  |  | Part Number |  | Stock
1 | C1 | 10uF | 493-12763-1-ND | CAP ALUM 10UF 20% 16V RADIAL | 25 | 0.098”
3 | C2, C3, C10 | 1.0uF | P15831CT-ND | CAP ALUM 1.0UF 50V 20% RADIAL | 12 | 0.098”
1 | C4 | 4.7uF | P5177-ND | CAP 4.7UF 50V ALUM LYTIC RADIAL | 9 | 0.079”
3 | C5, C9, C17 | 0.1uF | 399-9859-1-ND | CAP CER 0.1UF 50V Z5U RADIAL | 100 | 0.1”
2 | C6, C7 | 47pF | 399-7917-1-ND | CAP CER 47PF 50V C0G/NP0 0805 | 100 | 0805
1 | C16 | 0.01uF | P4922-ND | CAP CERAMIC MONO .01UF 50V 10% | 7
3 | C11, C13, C15 | 0.1uF | 1276-1007-1-ND | CAP CER 0.1UF 50V Y5V 0805 | 81 | 0805
1 | C12 | 0.001uF | 311-1127-1-ND | CAP CER 1000PF 50V X7R 0805 | 100 | 0805
1 | C14 | 10uF | 493-12763-1-ND | CAP ALUM 10UF 20% 16V RADIAL | 100
1 | C18 | 0.047uF | BC2686CT-ND | 0.047µF 50V Ceramic Capacitor X7R Radial | 9
2 | C19, C24 | 220uF | P5166-ND | 220µF 35V Aluminum Capacitors Radial | 5
5 | C20, C21, C22, C23, C25 | 1uF | 399-1284-1-ND | CAP CER 1UF 16V X7R 0805 | 8 | 0805
1 | D1 | 1N4001 | 1N4001MSCT-ND | RECTIFIER 1 AMP 50V DO-41 | 10
3 | D2, D3, D4 | RED | 160-1427-1-ND | LED 660NM RED WTR CLR 0805 SMD | 70 | 0805
1 | D5 | GRN | 160-1426-1-ND | LED GREEN CLEAR THIN 0805 SMD | 72 | 0805
10 | GND, J5, JP1, TP1, TP2, TP3, TP4, TP5, TP6 | Test Post | 929834-02-36-ND | CONN HEADER .100 SNGL STR 36POS | 50
1 | J1 | DIN 2.1mm | CP-102A-ND | CONN JACK POWER 2MM PCB | 6
1 | J2 | RJ-12 6-6 | A9010-ND | MOD JACK 6-6 LOW PROFILE W/STOPS | 3
1 | J3 | USB Micro-B | 609-4618-1-ND | CONN USB MICRO B RECPT SMT R/A | 2
1 | J7 | 5x2 Header | ED1543-ND | CONN HEADER VERT 10POS 2.54MM | 9
1 | L1 | 15uH | 732-2618-1-ND | FIXED IND 15UH 720MA 400 MOHM | 10
1 | L2 | 2.2mH | AIAP-01-222K-TCT-ND | FIXED IND 2.2MH 100MA 19 OHM TH | 8
1 | R1 | 2.2k | RHM2.2KKCT-ND | RES SMD 2.2K OHM 5% 0.4W 0805 | 95 | 0805
1 | R2 | 10k | 10K | RES 10K OHM 1/4W CARBON FILM | 12 | 0.4”
3 | R3, R6, R20 | 470 | A129745CT-ND | CRGCQ 0805 470R 1% | 100 | 0805
2 | R4, R5 | 27 | 311-27.0CRCT-ND | RES SMD 27 OHM 1% 1/8W 0805 | 100 | 0805
2 | R7, R19 | 1k | CF14JT1K00CT-ND | RES 1K OHM 1/4W 5% AXIAL | 100 | 0.4”
1 | R8 | 100k | CF14JT100KCT-ND | RES 100K OHM 1/4W 5% AXIAL | 100 | 0.4”
1 | R9 | 10k | 490-2970-ND | TRIMPOT CERM 10K OHM 12TRN TOP | 2
1 | R10 | 10 | CF14JT10R0CT-ND | RES 10 OHM 1/4W 5% CARBON FILM | 9 | 0.4”
8 | R11, R12, R13, R14, R15, R16, R17, R18 | 100k | A130146CT-ND | CRGCQ 0805 100K 5% | 98 | 0805
1 | SP1 | 8 ohm Speaker
1 | SW1 | SPDT | SSW-46 | SWITCH SPDT MINI-SLIDE PC | 94
1 | SW2 | RESET | PB-126 | SPST PC PUSH BUTTON | 100
1 | U1 | MCP1700 | MCP1700-3302E/TO-ND | IC REG LDO 3.3V 0.25A TO92-3 | 4 | TO-92
1 | U2 | dsPIC33EPxxxMC202 | DSPIC33EP32MC202-I/SP-ND | IC MCU 16BIT 32KB FLASH 28SDIP | 1 | 28SDIP
1 | U3 | FT230X | 768-1135-1-ND | IC USB SERIAL BASIC UART 16SSOP | 5 | 16SSOP
1 | U4 | LM386-3 | 296-43959-5-ND | IC AMP AUDIO PWR .7W MONO 8DIP | 10 | 8DIP
1 | U5 | SST25VF020B | SST25VF020B-80-4I-SAE-TCT-ND | IC FLASH 2MBIT 80MHZ 8SOIC | 2 | 8SIOC
1 | U6 | MCP6004 | MCP6004T-I/SLCT-ND | IC OPAMP GP 4 CIRCUIT 14SOIC | 10 | 14SIOC
