CmdrZin/chips_pic_examples/dsPIC33/Processing3/OScope4Ch/Processing3_GuiTest.rtf

Processing3_GuiTest.rtf
19jul20 ndp

Adding graphical GUI elements.
Processing3 > Sketch > Import Library > Add Library > ControlP5 > Install 2.2.6
Update example code..name > getName...arrayValue > getArrayValue..
Can't have an Item with the same name in two different RadioButton groups.
TODO: Add default settings to RadioButton groups.
