CmdrZin/chips_pic_examples/dsPIC33/dsPIC33_Sampler.X/docs/ADC_Debug.rtf

ADC_Debug.rtf
28jun20 ndp

ref1: Ch 16 ADC
ref2: Data sheet

Four channel is 500 kps max w/ 10 bit data. Channels 1,2,&3 are 10 bit.
Channel selection through PTG.
16 word conversion buffer.
w/ OpAmp (fig 23-1)[2]
AN3 Ch0 CH0Sx(00011) + CH0Nx(0) S&H0
AN0 Ch1 CH123Sx(0) + CH123Nx(00) S&H1
AN1 Ch2 CH123Sx(0) + CH123Nx(00) S&H2
AN2 Ch3 CH123Sx(0) + CH123Nx(00) S&H3
VCFG<2:0> select AVdd (+3.3), AVss(GND)

AD1CON1 1000 0000 1110 11x0
ADON 1 On
AD12B 0 10bit
FORM 00 Int 0000 00dd dddd dddd (char)(data>>2)
SSRC 111
SSRCG 0
SIMSAM 1 Simultaneous CHPS<1:0> = 01
ASAM 1 Auto-Start
DONE Status 1 = complete, 0 = in progress
AD1CON2 0000 0010 x000 0000
VCFG 000 Vrefh = AVdd, Vrefl = AVss
CHPS 10
SMPI 00000
AD1CON3 = 0000 0011 0001 1111 233kHz sample rate x four channels using interrupts.
SAMC 00011 3 Tad auto-sample..minimum 2..conversion takes 12 Tad.
ADCS<7:0> 00000100 4+1 Tcy Divider = 83ns ADC conversion clock..min 76ns
AD1CON4 0000 0000 0000 0000
0
AD1CHS123 0000 0000 0000 0000
CH123NB 00 VrefL
CH123SB 0 Same as CH123SA AN0, AN1, AN2
CH123NA 00 VrefL
CH123SA 0 Same as CH123SB AN0, AN1, AN2
ADxCHS0 0000 0011 0000 0011
CH0NB 0 VrefL
CH0SB 00011 AN3
CH0SA 00011 AN3

user.c : InitApp() for USER_FOUR_CHAN

Working, but a 50KHz noise signal on MPU input lines adding 3 or 4 bitsof noise.
