CmdrZin/chips_pic_examples/dsPIC33/rev3/dsPIC33_Sampler_Schematic_1_rev3.pdf

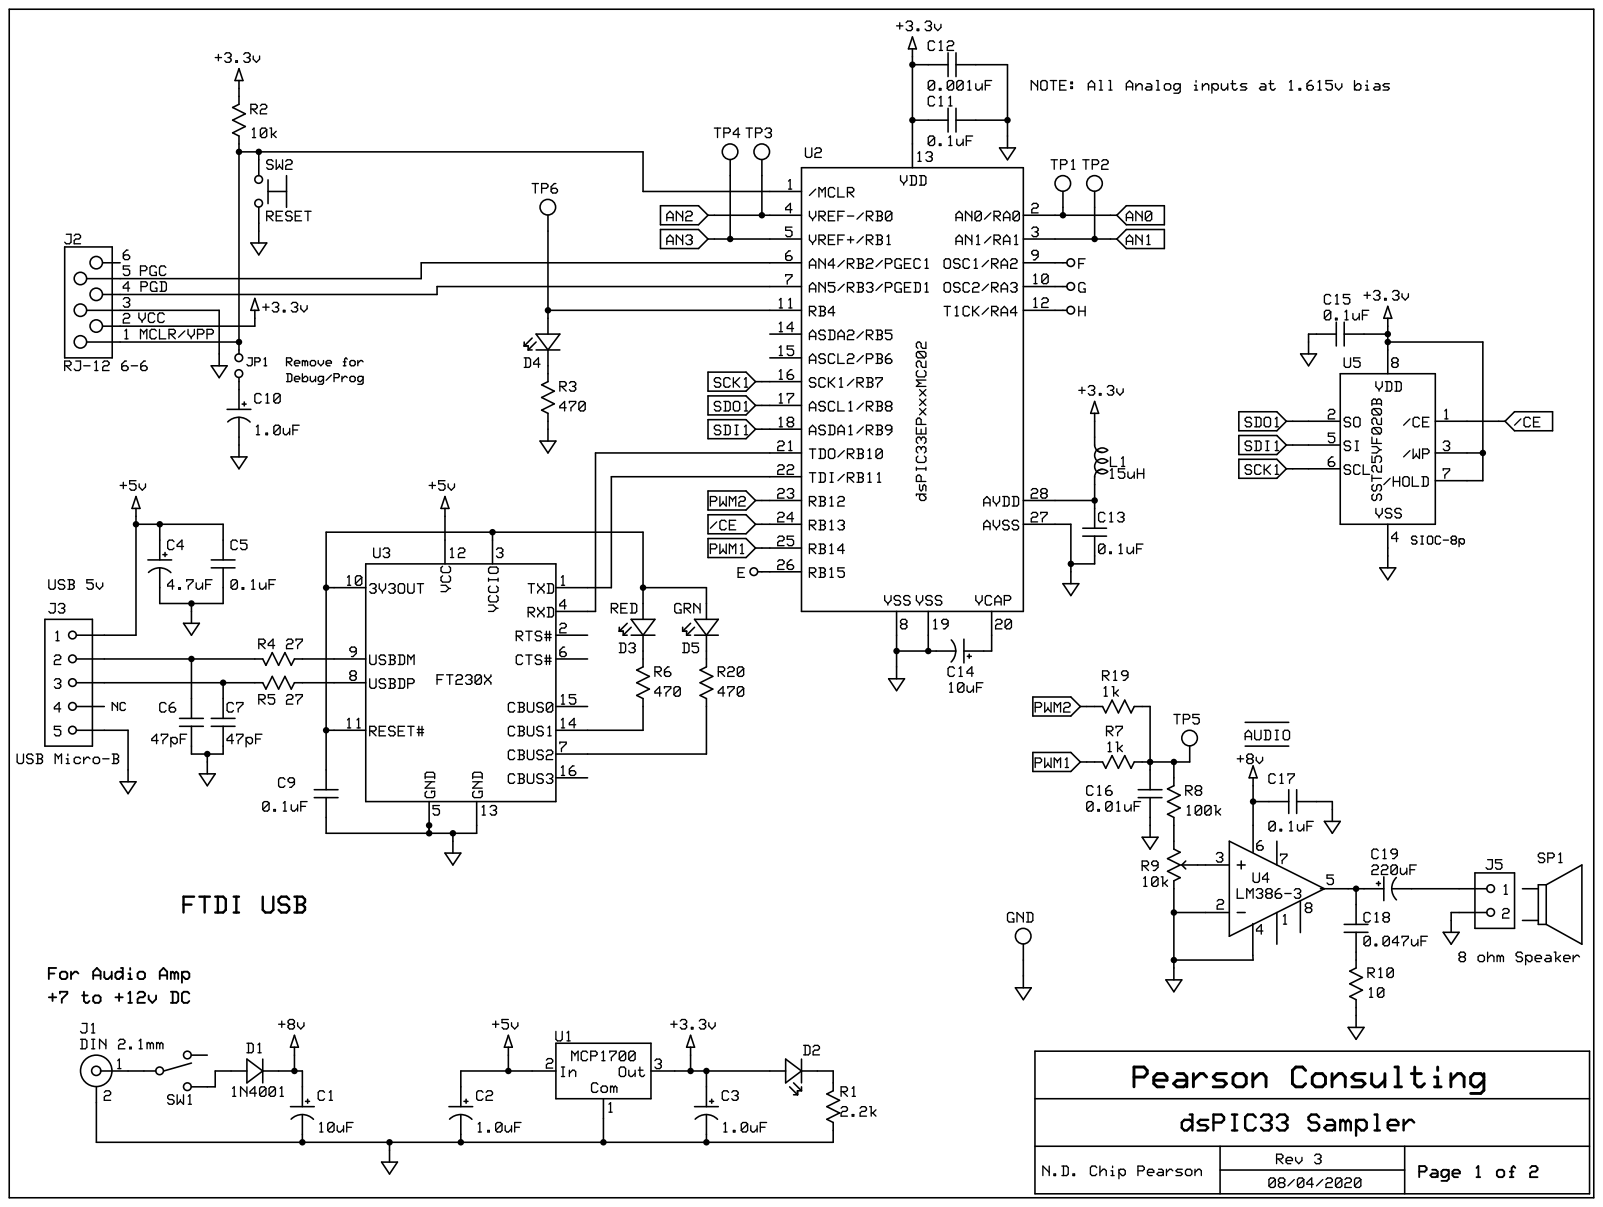
[picture p1: page 1]
