CmdrZin/chips_pic_examples/dsPIC33/rev3/dsPIC33_Sampler_Schematic_2_rev3.pdf

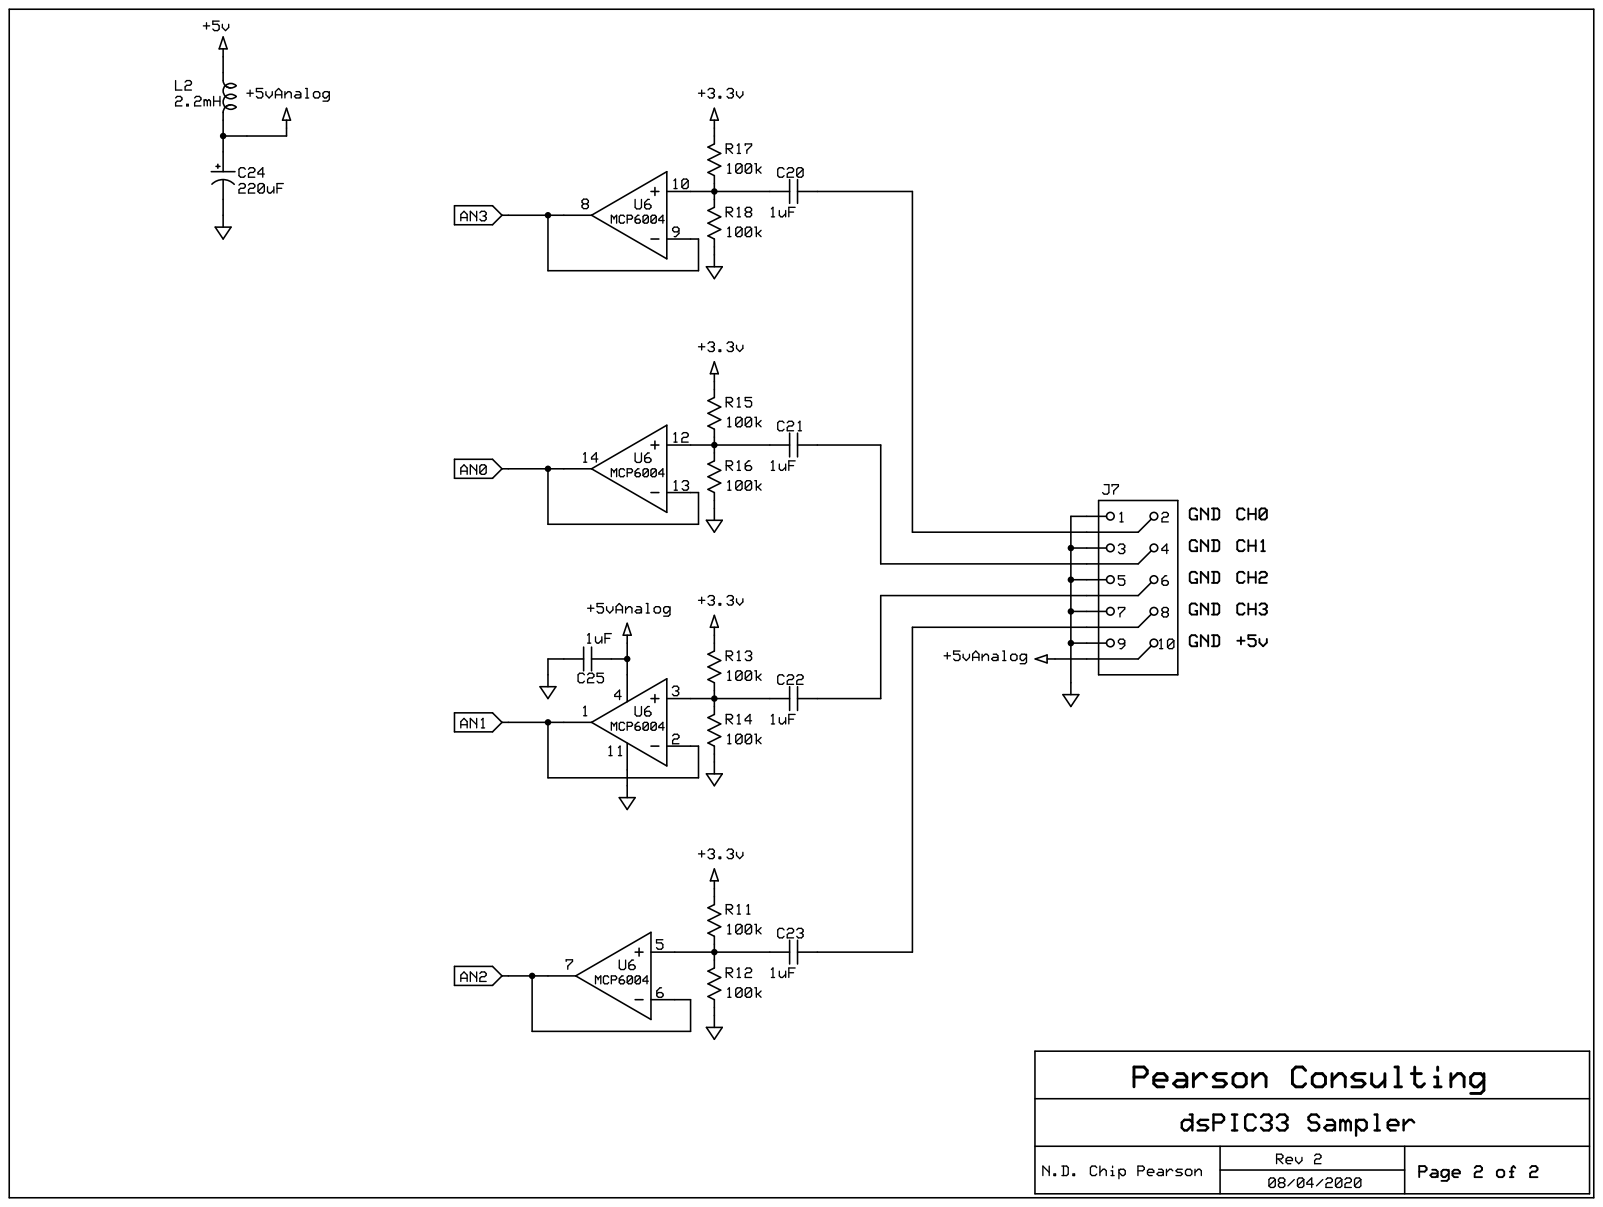
[picture p2: page 1]
