CmdrZin/chips_pic_examples/dsPIC33/rev0/dsPIC33_Sampler_1_rev0.pdf

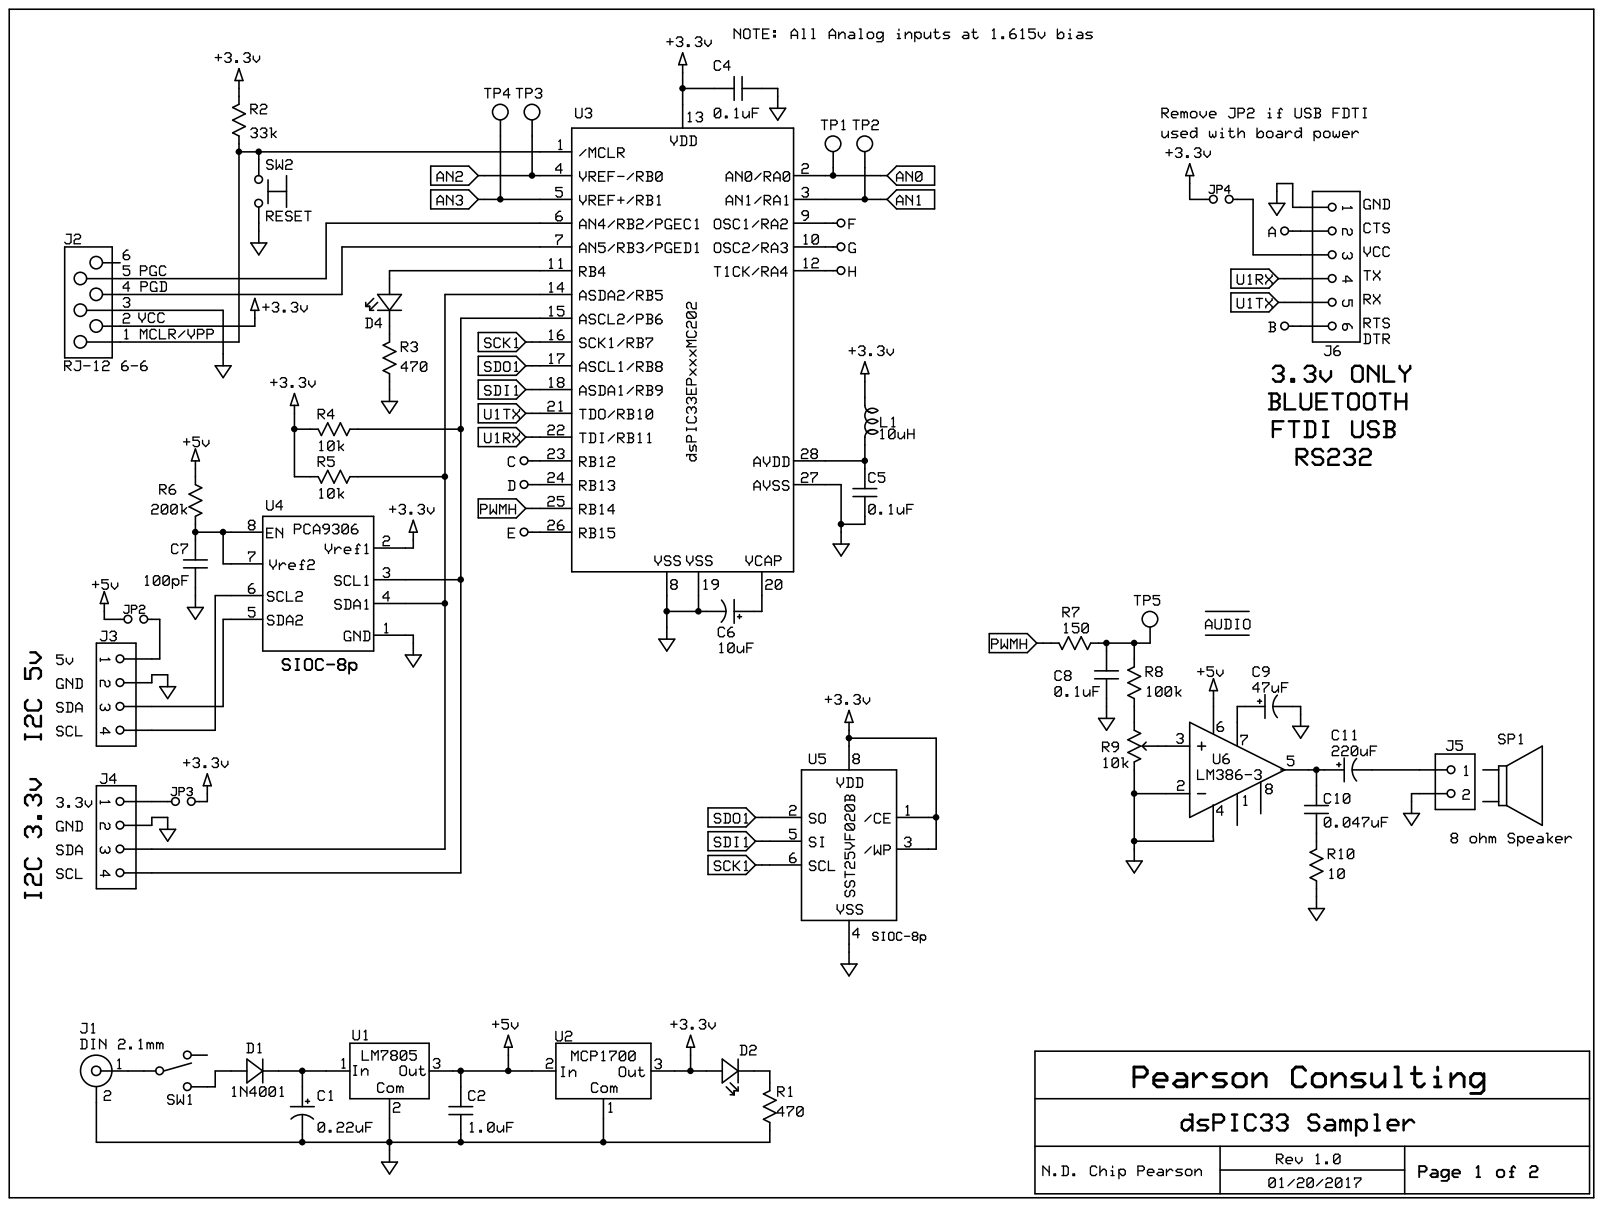
[picture p3: page 1]
