CmdrZin/chips_pic_examples/dsPIC33/rev0/dsPIC33_Sampler_2_rev0.pdf

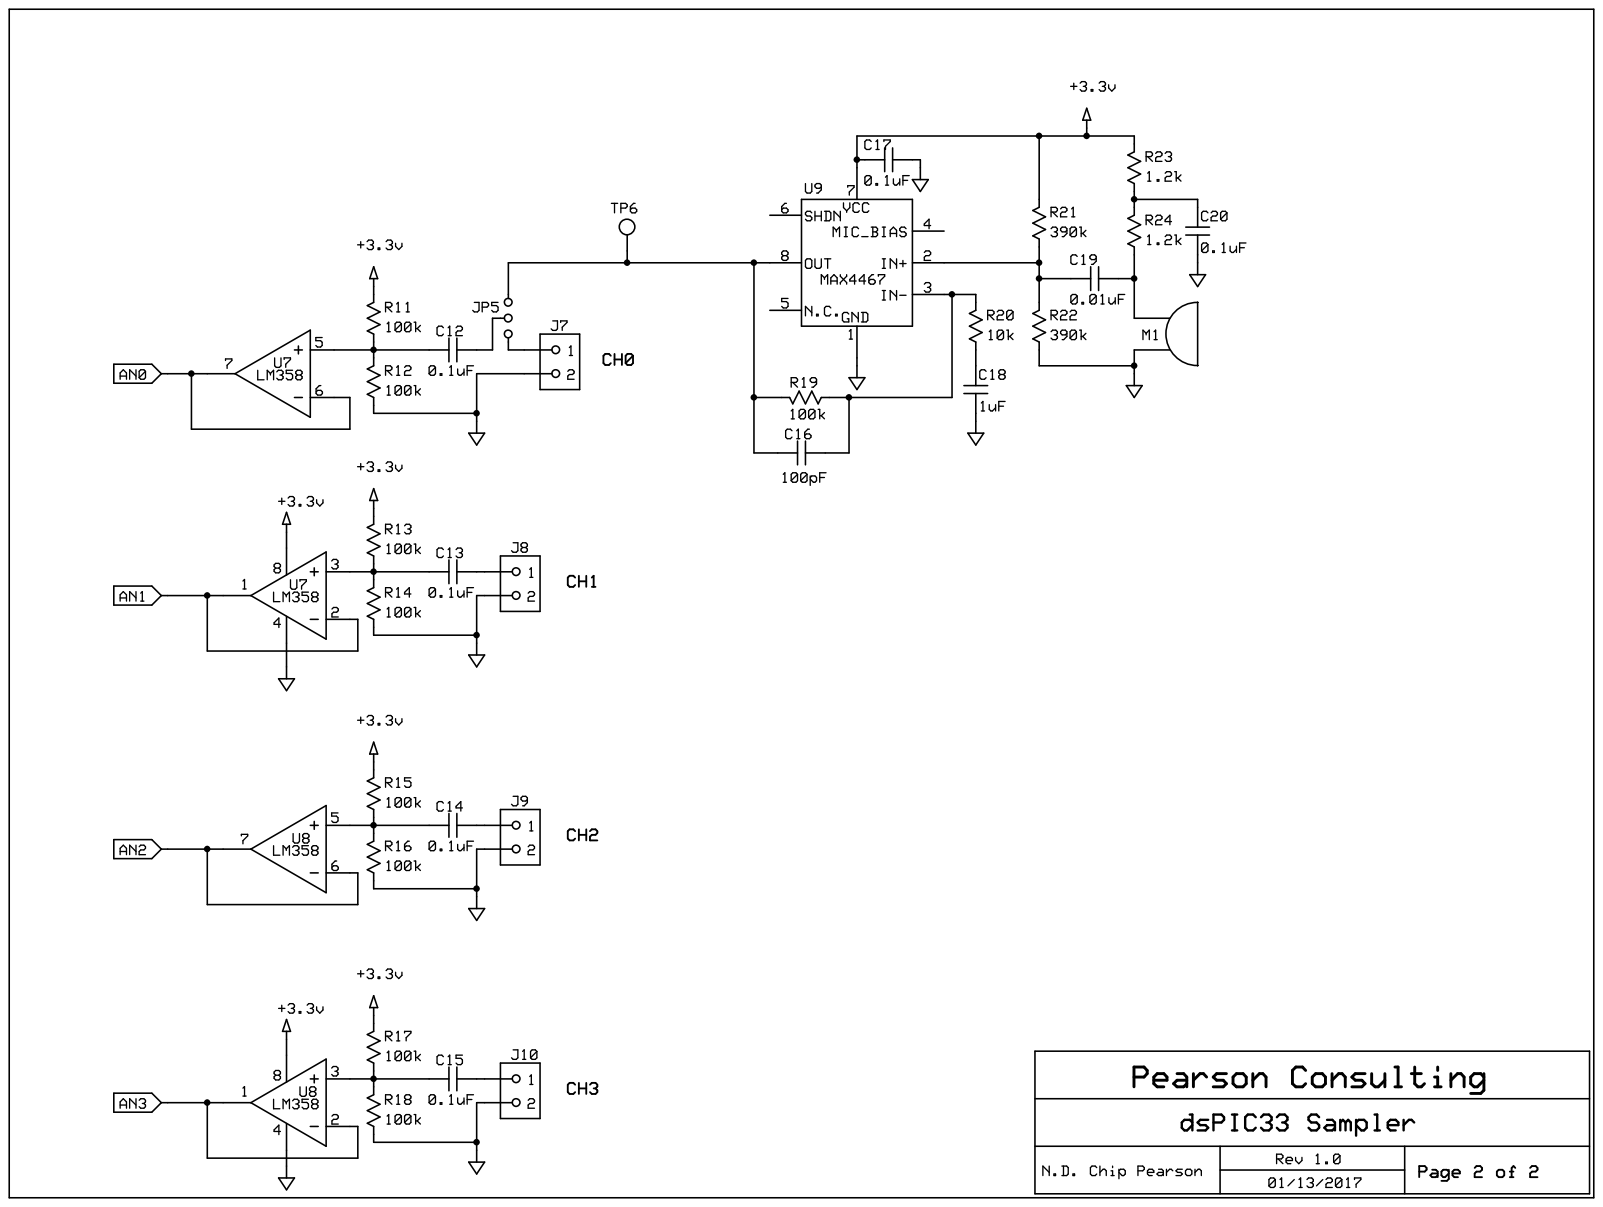
[picture p4: page 1]
