CmdrZin/chips_pic_examples/(list of files, drawings)

Other design files:
dsPIC33/dsPIC33_Sampler_r1.pcb
dsPIC33/dsPIC33_Sampler_r2.pcb
dsPIC33/dsPIC33_Sampler_r3.pcb
dsPIC33/rev0/dsPIC33_rev0.pcb
dsPIC33/rev3/dsPIC33_Sampler_r3.pcb
