CmdrZin/chips_pic_examples/dsPIC33/dsPIC33_Sampler.X/audio.c

/*
 * The MIT License (MIT)
 *
 * Copyright (c) 2016 Nels D. "Chip" Pearson (aka CmdrZin)
 *
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
 * File:   audio.c
 * Author: Chip
 *
 * Created on September 18, 2019, 11:12 AM
 */

/* Device header file */
#if defined(__XC16__)
#include <xc.h>
#elif defined(__C30__)
#if defined(__dsPIC33E__)
#include <p33Exxxx.h>
#elif defined(__dsPIC33F__)
#include <p33Fxxxx.h>
#endif
#endif

#include <stdbool.h>       /* Includes true/false definition                  */

#include "user.h"          /* User funct/params, such as InitApp              */
#include "audio.h"

typedef struct ttEntry {
  uint16_t note;       // note phase time
  uint16_t duration;   // play time. N * 2.72 us. max duration 1.784 sec.
} TT_ENTRY;

typedef struct tuneTable {
  char numEntries;       // number of note & duration entries
  TT_ENTRY notes[];
} TUNE_TABLE;

typedef enum { P_ATTACK, P_DECAY, P_SUSTAIN, P_RELEASE, P_IDLE } PHASE_STEP;

/* Globals */
uint16_t attackSteps;
uint16_t decaySteps;
uint16_t sustainSteps;
uint16_t releaseSteps;
uint16_t amplitudeStep;
PHASE_STEP phaseStep;
uint16_t phaseGain;
uint32_t phaseGainAccum;

static volatile uint16_t pwmDuty = 0;       // PWM duty % of 2048 period.
static volatile uint16_t duration = 0;      // total phase samples
static volatile uint16_t indexAccum = 0;    // large index tracker.
static volatile uint16_t accumStep = 0;     // large phase step.
static bool pause = false;

uint8_t tuneNotes;
uint8_t tuneIndex;

const TUNE_TABLE *playTable;              // Holds the current tune to play.

const TUNE_TABLE tune01 = {
  11,
  {
    { MA_E3, NOTE_EIGHT },
    { MA_E3, NOTE_EIGHT },
    { MA_E3, NOTE_QUARTER },
    { MA_E3, NOTE_EIGHT },
    { MA_E3, NOTE_EIGHT },
    { MA_E3, NOTE_QUARTER },
    { MA_E3, NOTE_EIGHT },
    { MA_G3, NOTE_EIGHT },
    { MA_C3, NOTE_EIGHT_DOT },
    { MA_D3, NOTE_SIXTEENTH },
    { MA_E3, NOTE_HALF }
  }
};

const TUNE_TABLE tune02 = {
  11,
  {
    { MA_E4, NOTE_EIGHT },
    { MA_E4, NOTE_EIGHT },
    { MA_E4, NOTE_QUARTER },
    { MA_E4, NOTE_EIGHT },
    { MA_E4, NOTE_EIGHT },
    { MA_E4, NOTE_QUARTER },
    { MA_E4, NOTE_EIGHT },
    { MA_G4, NOTE_EIGHT },
    { MA_C4, NOTE_EIGHT_DOT },
    { MA_D4, NOTE_SIXTEENTH },
    { MA_E4, NOTE_HALF }
  }
};

// 256 point sin wave +112 to -112. Use val+128 for 8bit PWM.
const char sinTable112[] = {
	0,   3,   5,   8,  11,  14,  16,  19,  22,  25,  27,  30,  33,  35,  38,  40,
	43,  45,  48,  50,  53,  55,  58,  60,  62,  64,  67,  69,  71,  73,  75,  77,
	79,  81,  83,  85,  87,  88,  90,  92,  93,  95,  96,  97,  99, 100, 101, 102,
	103, 104, 105, 106, 107, 108, 109, 109, 110, 110, 111, 111, 111, 112, 112, 112,
	112, 112, 112, 112, 111, 111, 111, 110, 110, 109, 109, 108, 107, 106, 105, 104,
	103, 102, 101, 100,  99,  97,  96,  95,  93,  92,  90,  88,  87,  85,  83,  81,
	79,  77,  75,  73,  71,  69,  67,  64,  62,  60,  58,  55,  53,  50,  48,  45,
	43,  40,  38,  35,  33,  30,  27,  25,  22,  19,  16,  14,  11,   8,   5,   3,
	0,  -3,  -5,  -8, -11, -14, -16, -19, -22, -25, -27, -30, -33, -35, -38, -40,
	-43, -45, -48, -50, -53, -55, -58, -60, -62, -64, -67, -69, -71, -73, -75, -77,
	-79, -81, -83, -85, -87, -88, -90, -92, -93, -95, -96, -97, -99,-100,-101,-102,
	-103,-104,-105,-106,-107,-108,-109,-109,-110,-110,-111,-111,-111,-112,-112,-112,
	-112,-112,-112,-112,-111,-111,-111,-110,-110,-109,-109,-108,-107,-106,-105,-104,
	-103,-102,-101,-100, -99, -97, -96, -95, -93, -92, -90, -88, -87, -85, -83, -81,
	-79, -77, -75, -73, -71, -69, -67, -64, -62, -60, -58, -55, -53, -50, -48, -45,
	-43, -40, -38, -35, -33, -30, -27, -25, -22, -19, -16, -14, -11,  -8,  -5, -3
};

// 256 point sin wave +448 to -448. Use val+1024 for 11bit PWM. TODO...
const int sinTable448[] = {
	0,   3,   5,   8,  11,  14,  16,  19,  22,  25,  27,  30,  33,  35,  38,  40,
	43,  45,  48,  50,  53,  55,  58,  60,  62,  64,  67,  69,  71,  73,  75,  77,
	79,  81,  83,  85,  87,  88,  90,  92,  93,  95,  96,  97,  99, 100, 101, 102,
	103, 104, 105, 106, 107, 108, 109, 109, 110, 110, 111, 111, 111, 112, 112, 112,
	112, 112, 112, 112, 111, 111, 111, 110, 110, 109, 109, 108, 107, 106, 105, 104,
	103, 102, 101, 100,  99,  97,  96,  95,  93,  92,  90,  88,  87,  85,  83,  81,
	79,  77,  75,  73,  71,  69,  67,  64,  62,  60,  58,  55,  53,  50,  48,  45,
	43,  40,  38,  35,  33,  30,  27,  25,  22,  19,  16,  14,  11,   8,   5,   3,
	0,  -3,  -5,  -8, -11, -14, -16, -19, -22, -25, -27, -30, -33, -35, -38, -40,
	-43, -45, -48, -50, -53, -55, -58, -60, -62, -64, -67, -69, -71, -73, -75, -77,
	-79, -81, -83, -85, -87, -88, -90, -92, -93, -95, -96, -97, -99,-100,-101,-102,
	-103,-104,-105,-106,-107,-108,-109,-109,-110,-110,-111,-111,-111,-112,-112,-112,
	-112,-112,-112,-112,-111,-111,-111,-110,-110,-109,-109,-108,-107,-106,-105,-104,
	-103,-102,-101,-100, -99, -97, -96, -95, -93, -92, -90, -88, -87, -85, -83, -81,
	-79, -77, -75, -73, -71, -69, -67, -64, -62, -60, -58, -55, -53, -50, -48, -45,
	-43, -40, -38, -35, -33, -30, -27, -25, -22, -19, -16, -14, -11,  -8,  -5, -3
};

int initAudioDDS(void) {
    playTable = &tune02;
    tuneNotes = playTable->numEntries;
    tuneIndex = 0;
    indexAccum = 0;
    accumStep = playTable->notes[tuneIndex].note;
    duration = playTable->notes[tuneIndex].duration;
    pause = false;

    initEnvelope(duration);
    ++tuneIndex;
    pwmDuty = 0 + 1024;             // initialize and add offset
    
    PTCON = 0x8000; // Enable PWM Mode
   
    return 0;
}


/* set time (in sample steps) of each phase of the envelope.
 * Percentage of tone duration for each phase.
 *   Attack    10%
 *   Decay     10%
 *   Sustain   70%
 *   Release   10%
 */
void initEnvelope(uint16_t duration) {
#if 1
  attackSteps = duration / 5;
  decaySteps = duration / 10;
  releaseSteps = duration / 5;
  sustainSteps = duration - attackSteps - decaySteps - releaseSteps;
#else
  attackSteps = sustain / 5;
  decaySteps = sustain / 10;
  sustainSteps = sustain / 2;
  releaseSteps = sustain / 5;
#endif
  phaseStep = P_ATTACK;
  amplitudeStep = (255<<8) / attackSteps;       // 16 bit fractional 8:8.
  phaseGain = 0;
  phaseGainAccum = 0;
  
  // DEBUG
//  setLed(true);
}

/* Called each sample.
 * Self tracking ADSR envelope.
 */
uint16_t getEnvelope() {
	// --attackSteps to 0 while increasing attackAmplitude from 0 to 255
    switch (phaseStep) {
        case P_ATTACK:
            if( attackSteps > 0 ) {
                --attackSteps;
                phaseGainAccum += amplitudeStep;
                phaseGain = (uint16_t)(phaseGainAccum);
            } else {
  // DEBUG
//  setLed(false);
                phaseStep = P_DECAY;
                amplitudeStep = (55<<8) / decaySteps;
            }
            break;
            
        case P_DECAY:
            if( decaySteps > 0 ) {
                --decaySteps;
                phaseGainAccum -= amplitudeStep;
                phaseGain = (uint16_t)(phaseGainAccum);
            } else {
  // DEBUG
//  setLed(true);
                phaseStep = P_SUSTAIN;
                amplitudeStep = 0;  // amplitude maintained during sustain phase.
            }
            break;
            
        case P_SUSTAIN:
            if( sustainSteps > 0 ) {
                --sustainSteps;
                // could do vibrato here. No modulation for now.
            } else {
  // DEBUG
//  setLed(false);
                phaseStep = P_RELEASE;
                amplitudeStep = (200<<8) / releaseSteps;
            }
            break;
            
        case P_RELEASE:
            if( releaseSteps > 0 ) {
                --releaseSteps;
                phaseGainAccum -= amplitudeStep;
                phaseGain = (uint16_t)(phaseGainAccum);
            } else {
                phaseStep = P_IDLE;
                amplitudeStep = 0;  // no more modulation.
            }
            break;
            
        case P_IDLE:
            break;
            
        default:
            phaseStep = P_IDLE;
            break;
    }
    
//    phaseGain = 0xF000;
    return phaseGain;
}

void __attribute__((__interrupt__, no_auto_psv)) _PWM1Interrupt(void) {
    uint16_t index;
//    static bool pause = false;
    long w;
    long g;
    
    PDC1 = pwmDuty; // from last look up

#if 1
    // Use ADSR envelope for each note.
        if (duration > 0) {
            --duration; // track the number of samples to go.
            indexAccum += accumStep; // advance phase index.
            index = indexAccum >> 8; // convert to table size index.
            // Adjust by envelope.
#if 0
            pwmDuty = (long)((sinTable448[index] << 3) + 1024); // generate new duty %. 8bit to 11bit for testing.
#else
            w = (sinTable448[index] << 3); // generate new duty %. 8bit to 11bit for testing.
            g = getEnvelope() * w;
            pwmDuty = (int)(g >> 16) + 1024;
#endif
        } else {
            // get next note.
            if (tuneIndex < tuneNotes) {
                accumStep = playTable->notes[tuneIndex].note;
                duration = playTable->notes[tuneIndex].duration;
                indexAccum = 0;
                pwmDuty = 0 + 1024;
                initEnvelope(duration);
                ++tuneIndex;
            } else {
                // all done. Could also disable PWM here.
                pwmDuty = 0;
                PTCON = 0x0000; // Disable PWM Mode
            }
        }
#else
    // Simple pause between notes.
    if (pause) {
        if (duration > 0) {
            --duration; // track the number of samples to go.
        } else {
            // When pause is finished, play next note.
            pause = false;
            // get next note.
            if (tuneIndex < tuneNotes) {
                accumStep = playTable->notes[tuneIndex].note;
                duration = playTable->notes[tuneIndex].duration;
                indexAccum = 0;
                pwmDuty = 0 + 1024;
                ++tuneIndex;
            } else {
                // all done. Could also disable PWM here.
                pwmDuty = 0;
            }
        }
    } else {
        if (duration > 0) {
            --duration; // track the number of samples to go.
            indexAccum += accumStep; // advance phase index.
            index = indexAccum >> 8; // convert to table size index.
            //        pwmVal = sinTable448[index]+1024;   // generate new duty %.
            pwmDuty = (sinTable448[index] << 3) + 1024; // generate new duty %. 8bit to 11bit for testing.
        } else {
            // When note is finished, do a small pause.
            duration = 8000;
            pwmDuty = 0;
            pause = true;
        }
    }
#endif

    IFS5bits.PWM1IF = 0; // reset interrupt flag
}
