CmdrZin/chips_pic_examples/(commit log)

2017-01-08 New dsPIC33 project
    High speed DSP and ADC sampler project using a dsPIC33 and 2Mb flash
    storage.
    [OH_dsPIC33.pcb, dsPIC33_Sampler.sch]
2017-01-09 One channel ADC works
    One channel 75 kHz ADC 12 sampling working.
2017-01-20 Four channel simultaneous added
    Cleaned up schematics. Completed board layout and BOM. Added four
    channel simultaneous and alternate clock settings.
    [BOM_dsPIC33_Sampler_Rev1_0.ods, OH_dsPIC33.pcb, dsPIC33.pcb, dsPIC33_Sampler.sch]
2017-01-20 Reset and 3.3v device changes
    Changes reset circuit to match Microchip ref. Changed 3.3v regulator
    from SOT-23 to TO-92.
    [BOM_dsPIC33_Sampler_Rev1_0.ods, dsPIC33.pcb, dsPIC33_Sampler.sch]
2017-01-21 Added auto-sample/auto-convert
    Added auto-sample/auto-convert to four channel mode. Added MIT license
    to code and a notes file on CPU clock and ADC timing configuration.
2019-09-13 Interrupt and serial added
    dsPIC33EP running at 60MHz. Four channel simultaneous sample ADC at 200KHz sample rate. 512x4 byte buffer collection. 115.2k baud serial output.
    Processing3 code included for serial display.
2020-07-17 Added 4-ch Processing3 display.
    Added an initial display for 4 signal traces in Processing3. Still need to be tied to serial input from dsPIC33 board.
    Improved four channel sampleing code.
    Enhanced Audio generator for wider range of frequencies.
    [BOM_dsPIC33_Sampler_Rev1_0.ods, BaudRateCalcs.ods, dsPIC33_Sampler_r1.pcb, dsPIC33_Sampler_r1.sch, dsPIC33_Sampler_r2.pcb, dsPIC33_Sampler_r2.sch]
2020-07-28 Improved Processing3 display
    Improved display. Added Control Panel GUI. Added Serial interface.
    [dsPIC33_Sampler_rev0.sch, dsPIC33_rev0.pcb]
2020-08-14 Rev3 started with embedded USB
    Removed mic, preamp, and I2C interface. Add FTDI chip for direct USB support and to provide board power. +9v only needed for audio output amp. Separated digital and analog grounds. Isolated digital and analog power. Provided for sterio audio out.
    [BOM_dsPIC33_Sampler_Rev3_0.ods, dsPIC33_Sampler_r3.pcb, dsPIC33_Sampler_r3.sch]
2020-08-17 Improved Serial and Processing3 Display
    Updated the serial data format to better support the Processing3 OScope display. Four channels of 512 bytes are transfered each time the local buffer fills up.
    Development is finish for this version. The Rev3 board is cleaner and should be noise free (to the degree that I can make it) and easier to interface to since it also has build in USB for power and serial.
    [OScope4Ch.pde, SerialIO.pde, interrupts.c, main.c, user.c]
